akod0883/ARC_Machine_Availability/README.md

# ARC Machine Availability

## Description of Files
 `website/templates/` - This repository contains all the html templates used for the different parts of the website

 `create_db,py` - File automates the creation of the database used in the project

 `db.yaml` - SQL credentials used to start up SQL db

 `main.py` - runner file

 `scripts/` - network scripts that handle the MQTT communication between the sensors used

 `deliverables/` - written artifacts to pitch, describe, and present the project
